inaciose/MC6809x/explorations/freerun/readme.md

Teste free run.

Os dois MC6809P que tenho funcionaram. consumos: 10mA e 11mA.

Inicialmente esqueci-me do condensador de 100n no VCC do MC6809. Não aparece no esquema mas deve ser colocado.
Adicionei duas imagens com a variação do VCC com o condensador. Todas as outras imagens são sem o condensador, mas não vi variações significativas nos sinais.
