inaciose/MC6809x/explorations/readme.md

Exploração de sistemas usados em MC6809 SBC
