inaciose/MC6809x/explorations/clock_circuit/clock_circuit.png

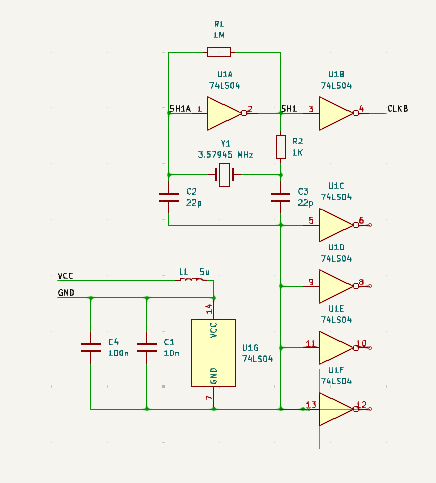
explorations/clock_circuit/clock_circuit.png
