inaciose/MC6809x/explorations/clock_circuit/clock_new.jpg

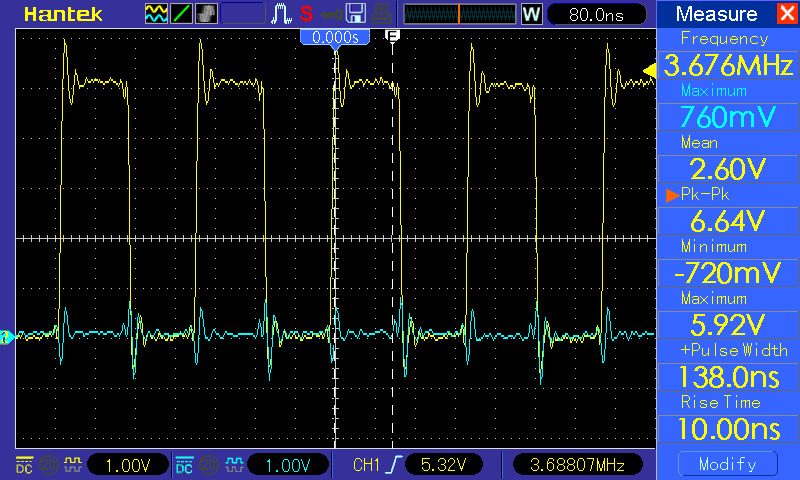
explorations/clock_circuit/clock_new.jpg
