inaciose/MC6809x/explorations/clock_circuit/vcc_gnd_new_080ns.jpg

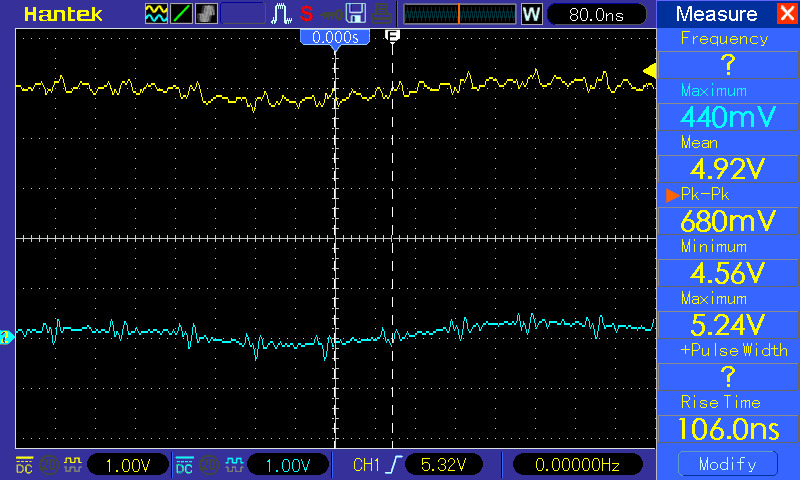
explorations/clock_circuit/vcc_gnd_new_080ns.jpg
