inaciose/MC6809x/explorations/freerun/A2.jpg

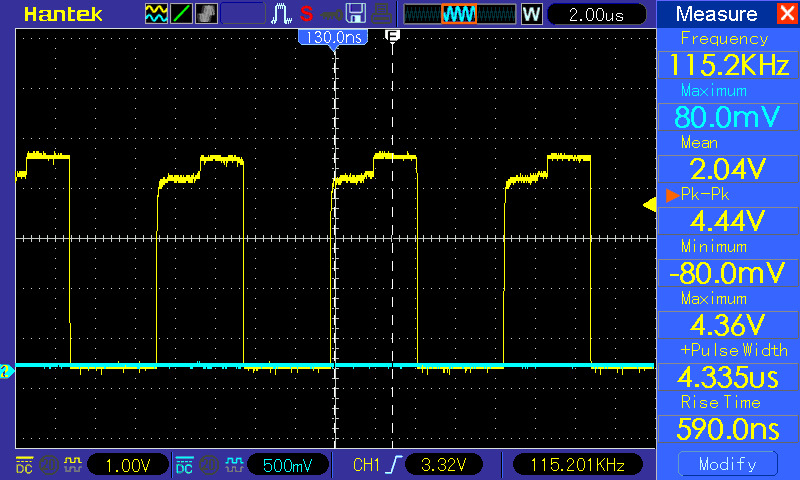
explorations/freerun/A2.jpg
