inaciose/MC6809x/explorations/freerun/A3.jpg

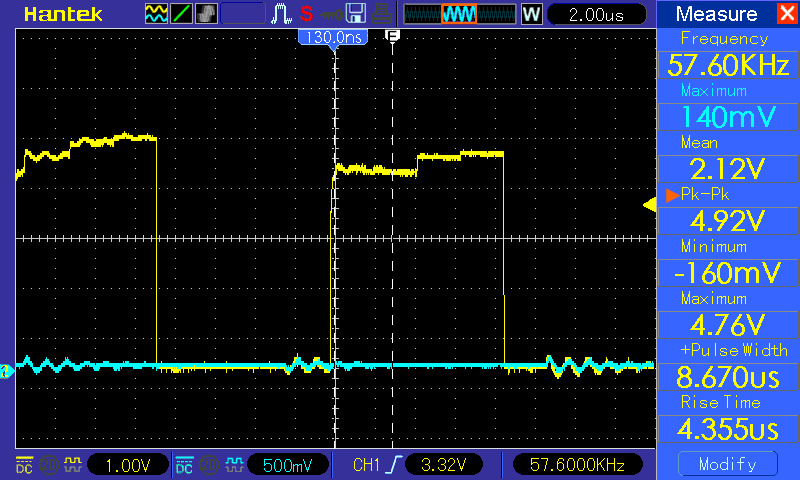
explorations/freerun/A3.jpg
