inaciose/MC6809x/explorations/freerun/E.jpg

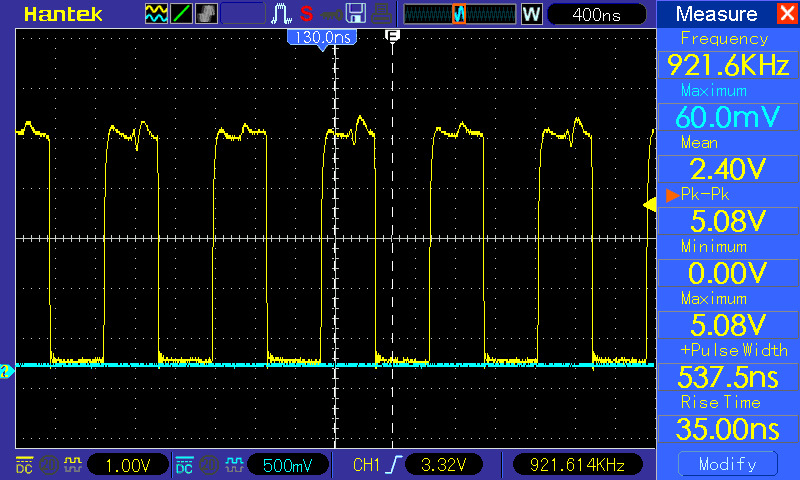
explorations/freerun/E.jpg
