inaciose/MC6809x/explorations/freerun/MC6809_free_run_circuit.png

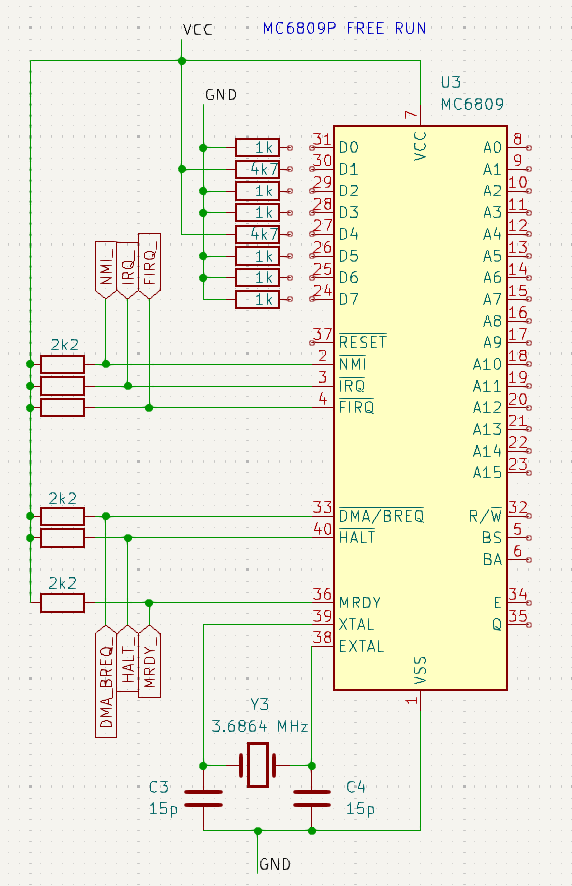
explorations/freerun/MC6809_free_run_circuit.png
