inaciose/MC6809x/explorations/freerun/vcc_4us.jpg

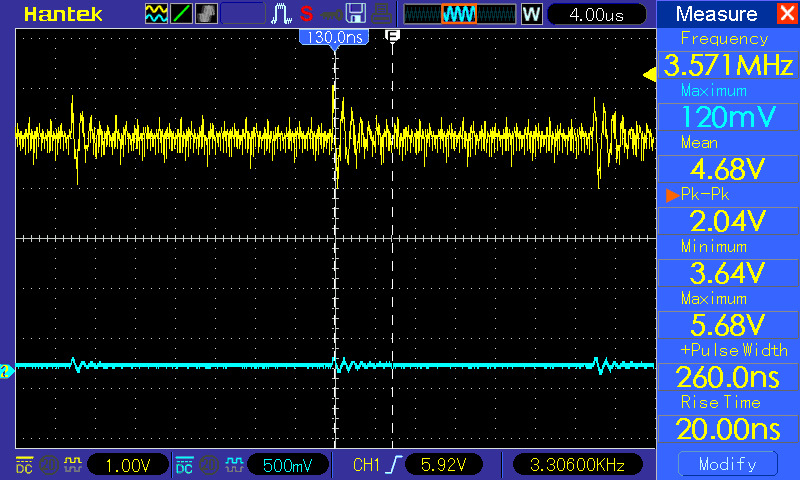
explorations/freerun/vcc_4us.jpg
