inaciose/MC6809x/explorations/freerun/vcc_4us_wcap100n.jpg

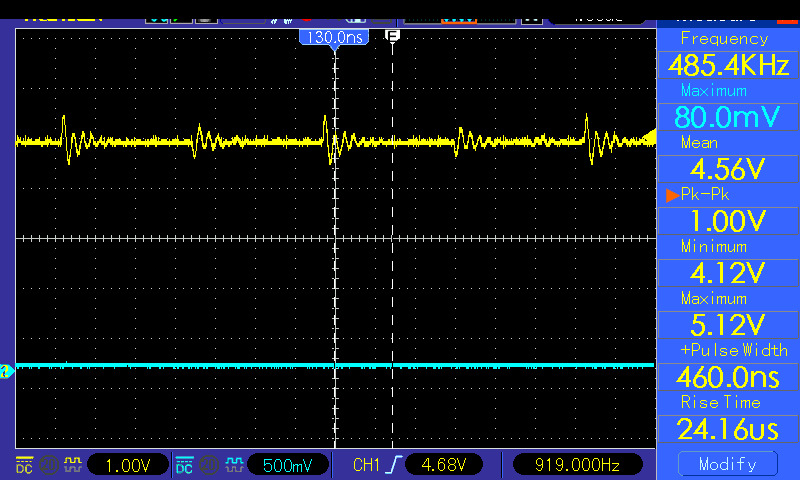
explorations/freerun/vcc_4us_wcap100n.jpg
