inaciose/MC6809x/explorations/MC6809_SBC1/breadboard.jpg

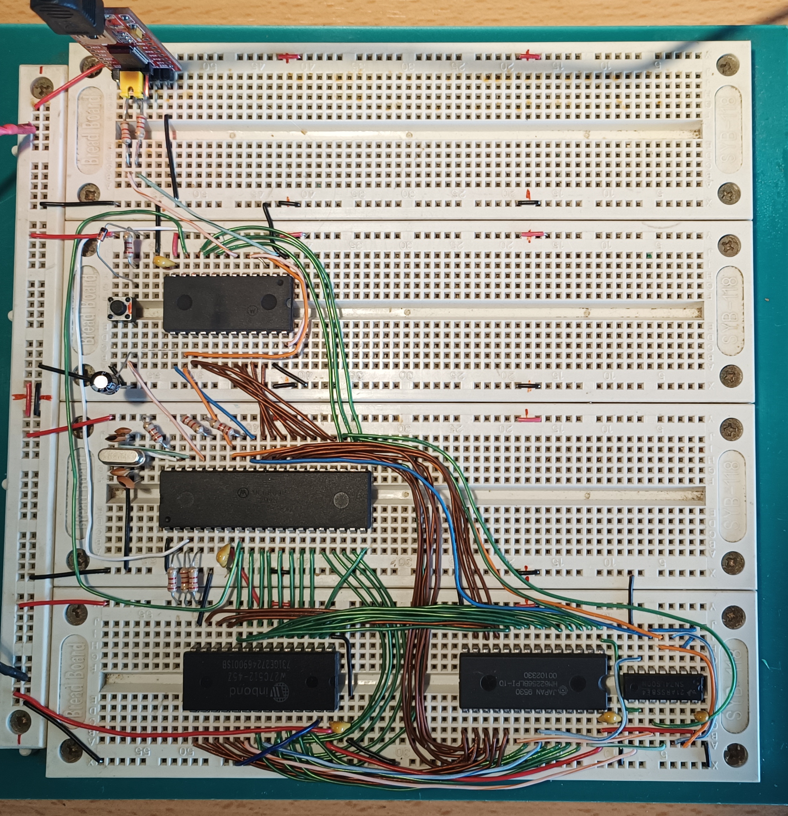
explorations/MC6809_SBC1/breadboard.jpg
