inaciose/MC6809x/explorations/MC6809_SBC2/GALs/LA-captures/MC6809-sbc2a-output-read-write1.png

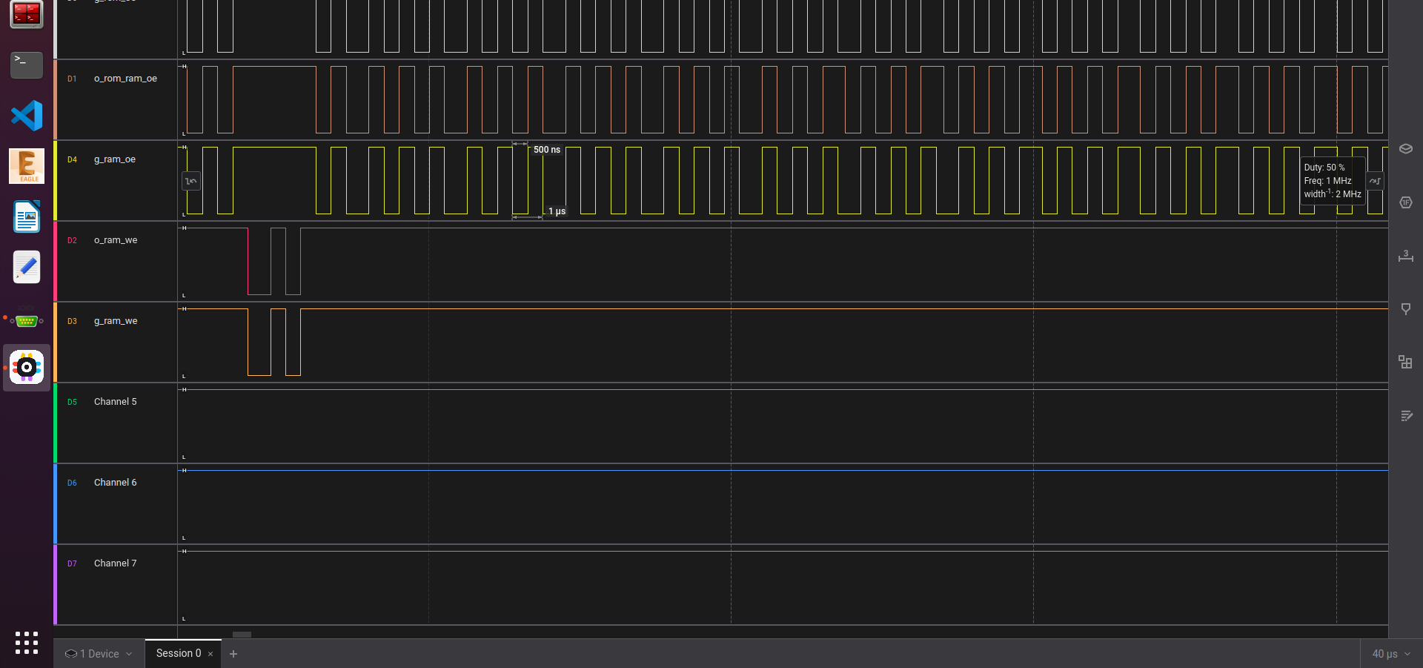
explorations/MC6809_SBC2/GALs/LA-captures/MC6809-sbc2a-output-read-write1.png
