inaciose/MC6809x/explorations/MC6809_SBC2/MC6809-SBC2A-BB.jpeg

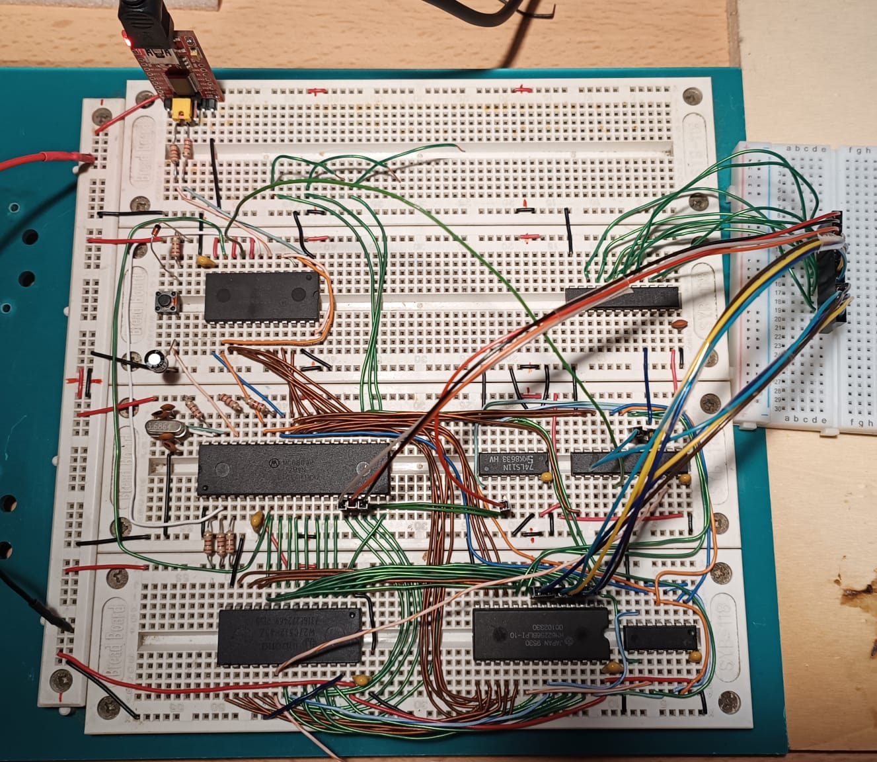
explorations/MC6809_SBC2/MC6809-SBC2A-BB.jpeg
