inaciose/MC6809x/explorations/MC6809_SBC2/MC6809-SBC2A-ROM-FIRST-BYTES-OK.png

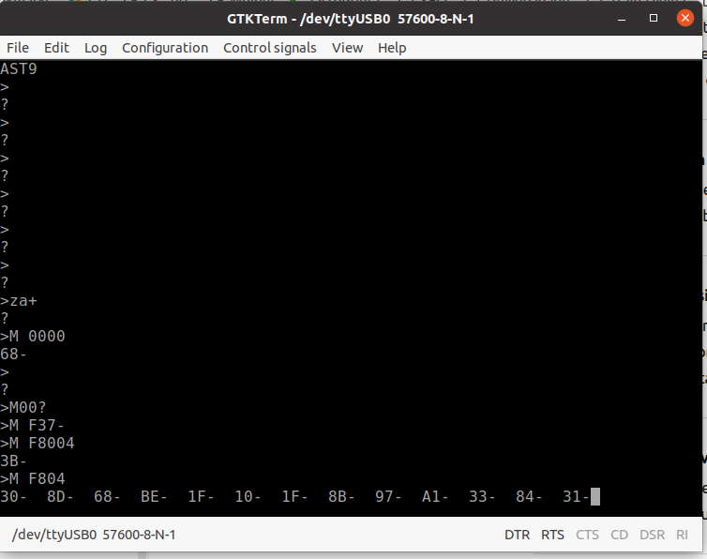
explorations/MC6809_SBC2/MC6809-SBC2A-ROM-FIRST-BYTES-OK.png
