inaciose/MC6809x/explorations/MC6809_SBC2/MC6809-SBC2B-BB_32K.jpg

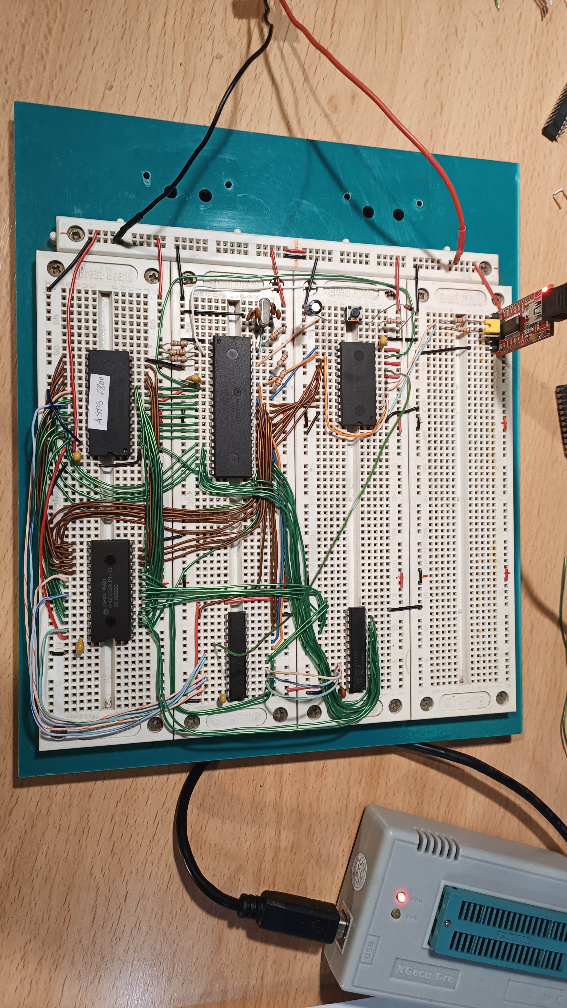
explorations/MC6809_SBC2/MC6809-SBC2B-BB_32K.jpg
