inaciose/MC6809x/explorations/MC6809_SBC2/MC6809-SBC2C-BB_64K.jpg

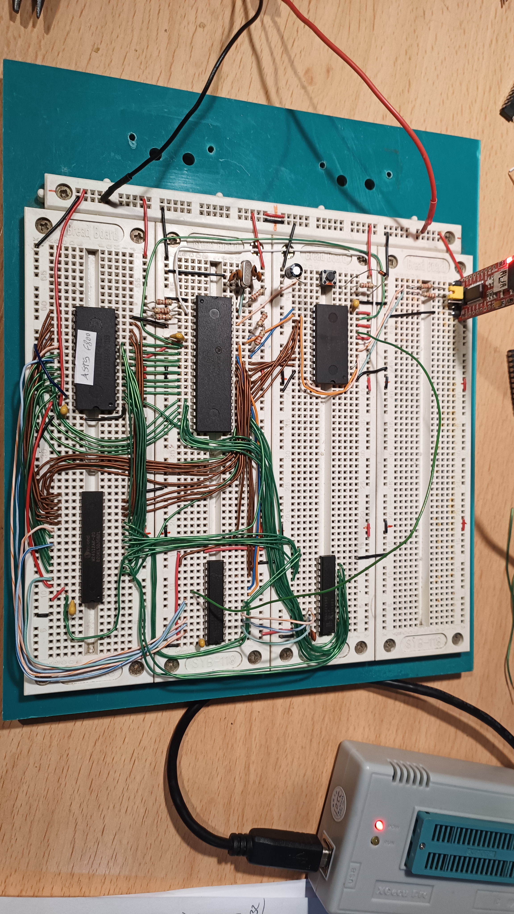
explorations/MC6809_SBC2/MC6809-SBC2C-BB_64K.jpg
