inaciose/MC6809x/explorations/MC6809_SBC3/mc6809_47_bb.jpg

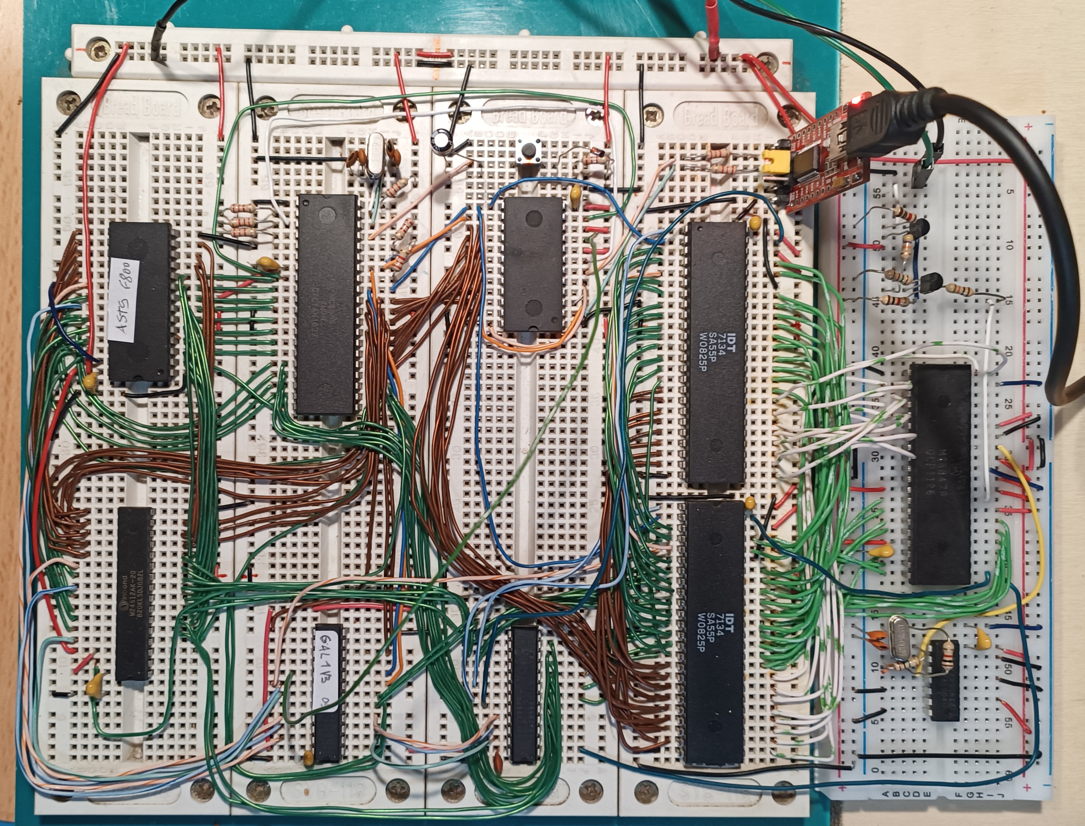
explorations/MC6809_SBC3/mc6809_47_bb.jpg
