inaciose/MC6809x/explorations/singlestep/68kdtack_button_pressed_80ns.jpg

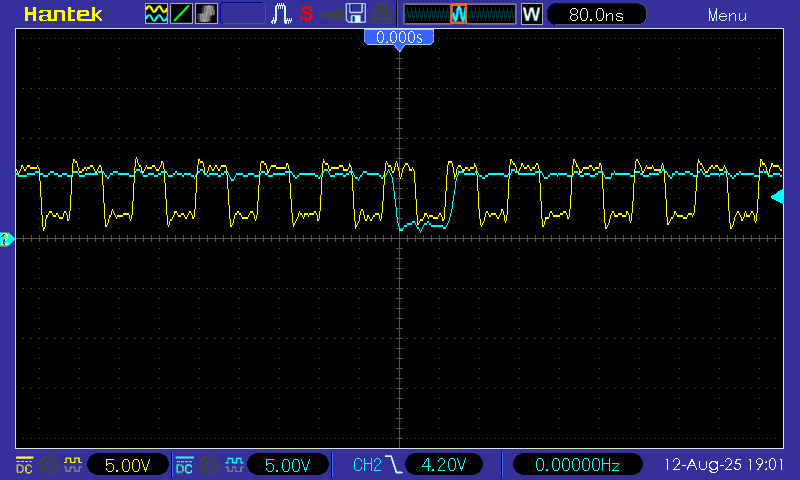
explorations/singlestep/68kdtack_button_pressed_80ns.jpg
