inaciose/MC6809x/explorations/singlestep/68kdtack_waiting_for_button.jpg

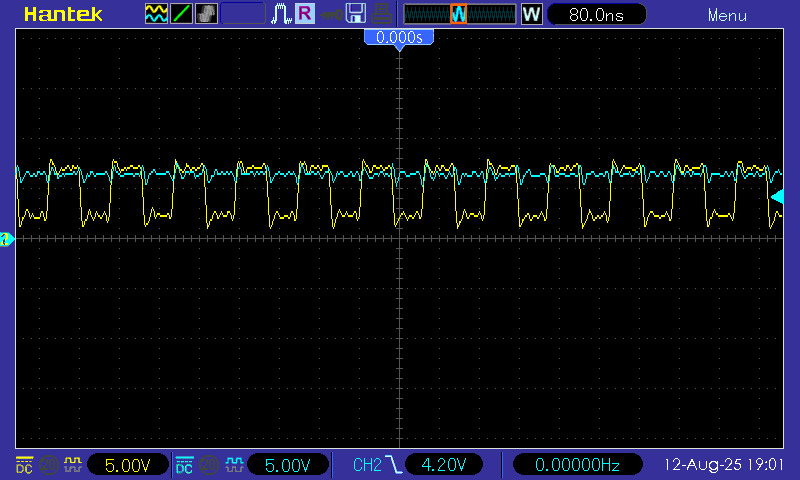
explorations/singlestep/68kdtack_waiting_for_button.jpg
