inaciose/MC6809x/explorations/singlestep/IMG_20250831_115116.jpg

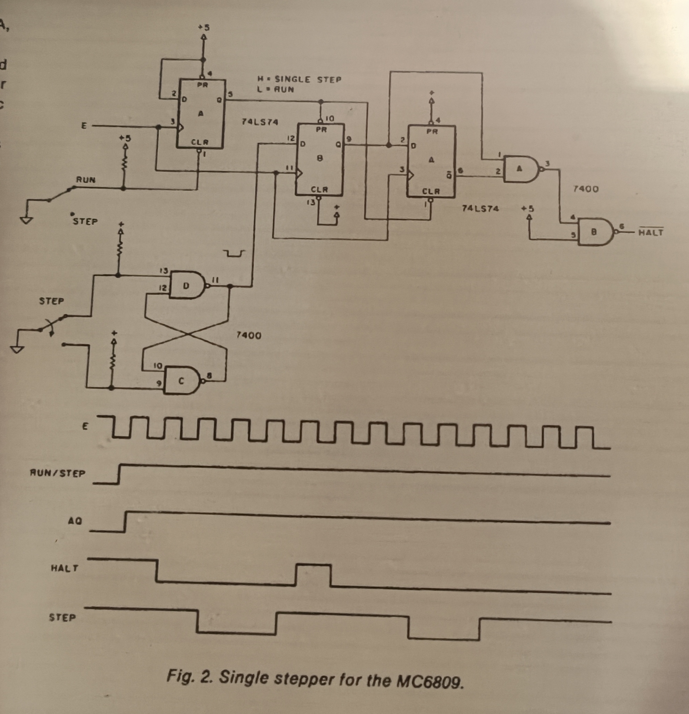
explorations/singlestep/IMG_20250831_115116.jpg
