inaciose/MC6809x/explorations/MC6809_SBC1/MC6809_SBC1_FW/bom.ods

Parts List – 6809 Single Board Computer
Identifier | Qty | Pins | Part | Description | Value | Comments
C1 | 1 | 2 | - | Capacitor, Electrolytic | 10uF | 10V or higher
C2-C3 | 2 | 2 | - | Capacitor, ceramic | 18pF | Or similar value
C3 | 1 | 2 | - | Capacitor, ceramic | 18pF | Or similar value
C4-C8 | 5 | 2 | - | Capacitor, ceramic | 0.1uF | Bypass caps, 1 per IC
D1 | 1 | 2 | 1N914 | Diode, small signal | - | Or 1N4148
H1 | 1 | 2 | - | 1x2 header + jumper | - | USB power jumper
H2 | 1 | 32 | - | 2x16 header | - | Expansion connector
LED1 | 1 | 2 | - | LED, red | - | Power LED
P1 | 1 | 6 | - | 1x6 header | - | For USB to serial module
R1 | 1 | 2 | - | Resistor | 330R | For power LED (adjust value for desired brightness)
RN1 | 1 | 9 | - | SIP resistor, 9X1 | 2K2 | Pullups
SW1 | 1 | 4 | - | Switch, momentary, SPST | - | Reset switch
U1 | 1 | 24 | 68B50 | ACIA | - | Be sure to get “B” part
U2 | 1 | 28 | 27C128 | 16K EPROM | - | Or 27128
U3 | 1 | 28 | 62256 | 32K Static RAM | - | Speed not critical
U4 | 1 | 40 | 68B09 | Microprocessor | - | Be sure to get B version and not 68089E
U5 | 1 | 14 | 74LS00 | Quad 2-input NAND gate | -
X1 | 1 | 2 | - | Crystal, 7.3728 MHz | - | Clock
- | 1 | 6 | - | FTDI module | - | USB to serial module. e.g. FTDI Friend
- | - | - | - | IC sockets | - | As needed
