inaciose/MC6809x/explorations/MC6809_SBC2/MC6809_SBC2_schematic.pdf

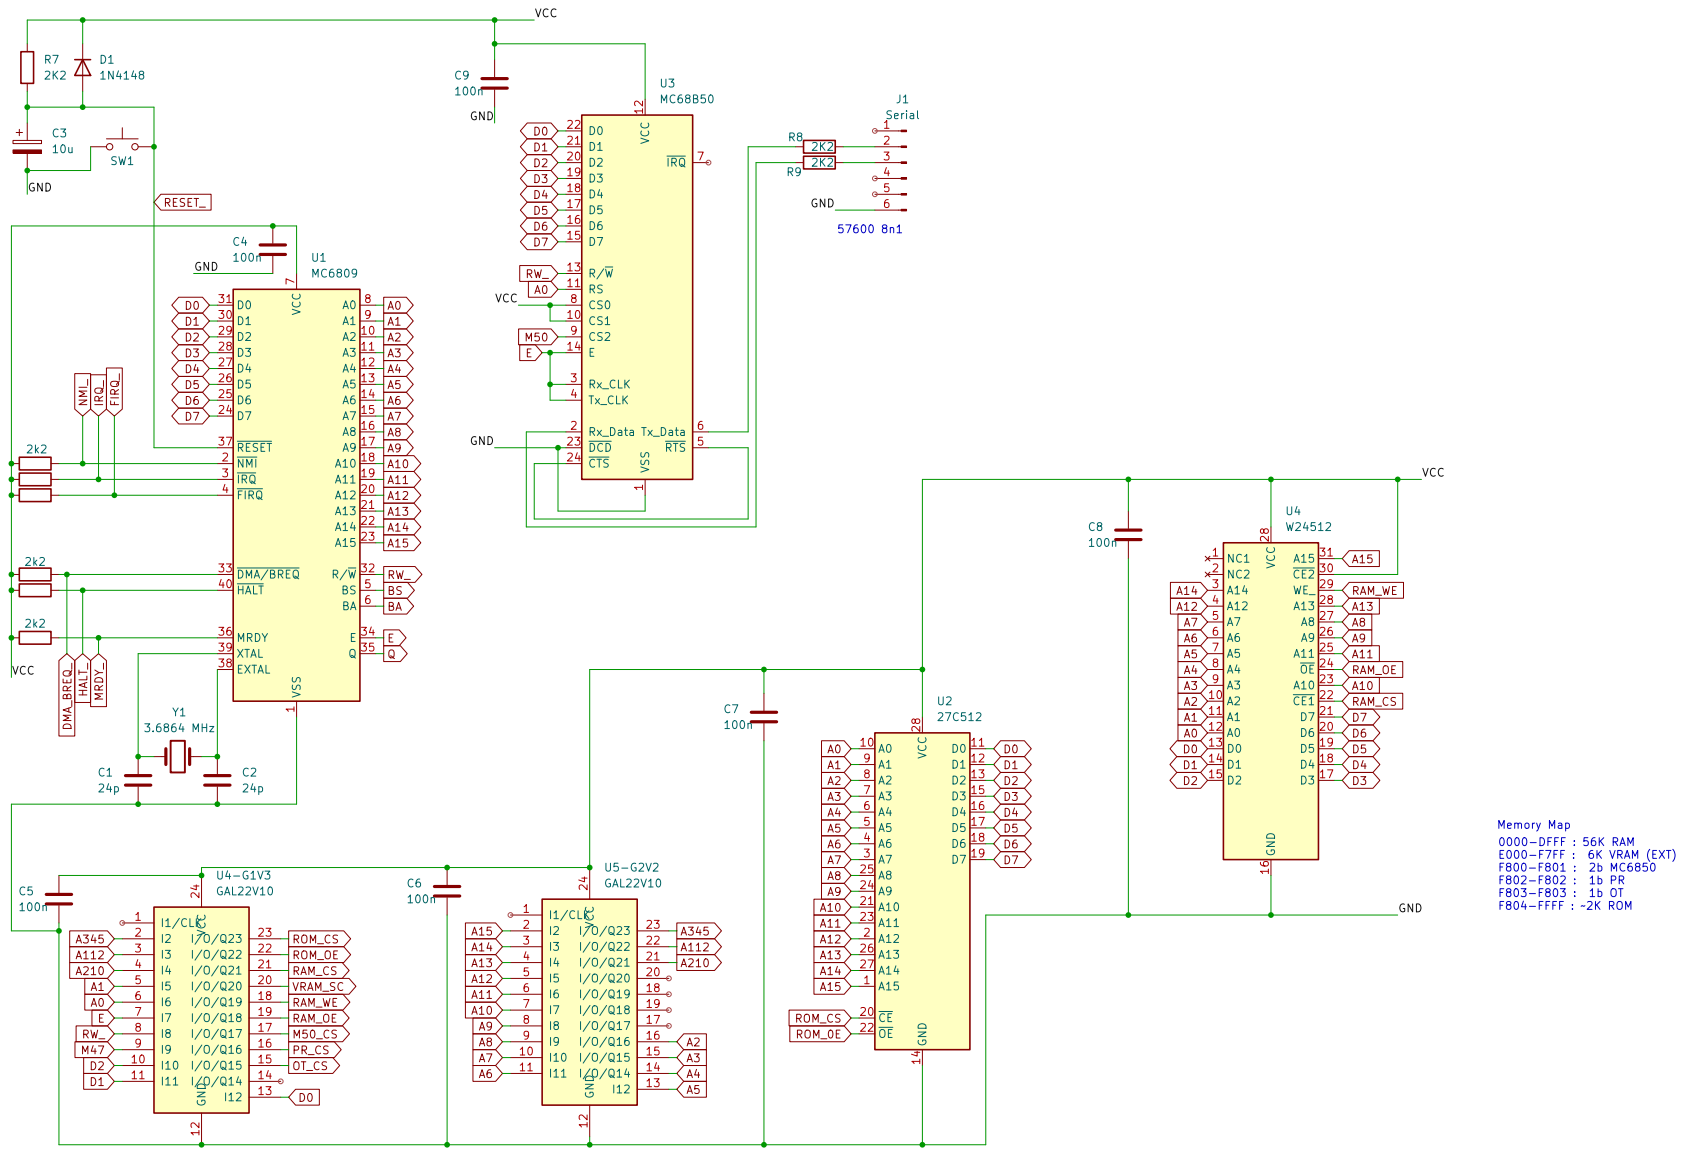
[picture p24: page 1]
