inaciose/MC6809x/explorations/MC6809_SBC1/MC6809_SBC1_schematic.pdf

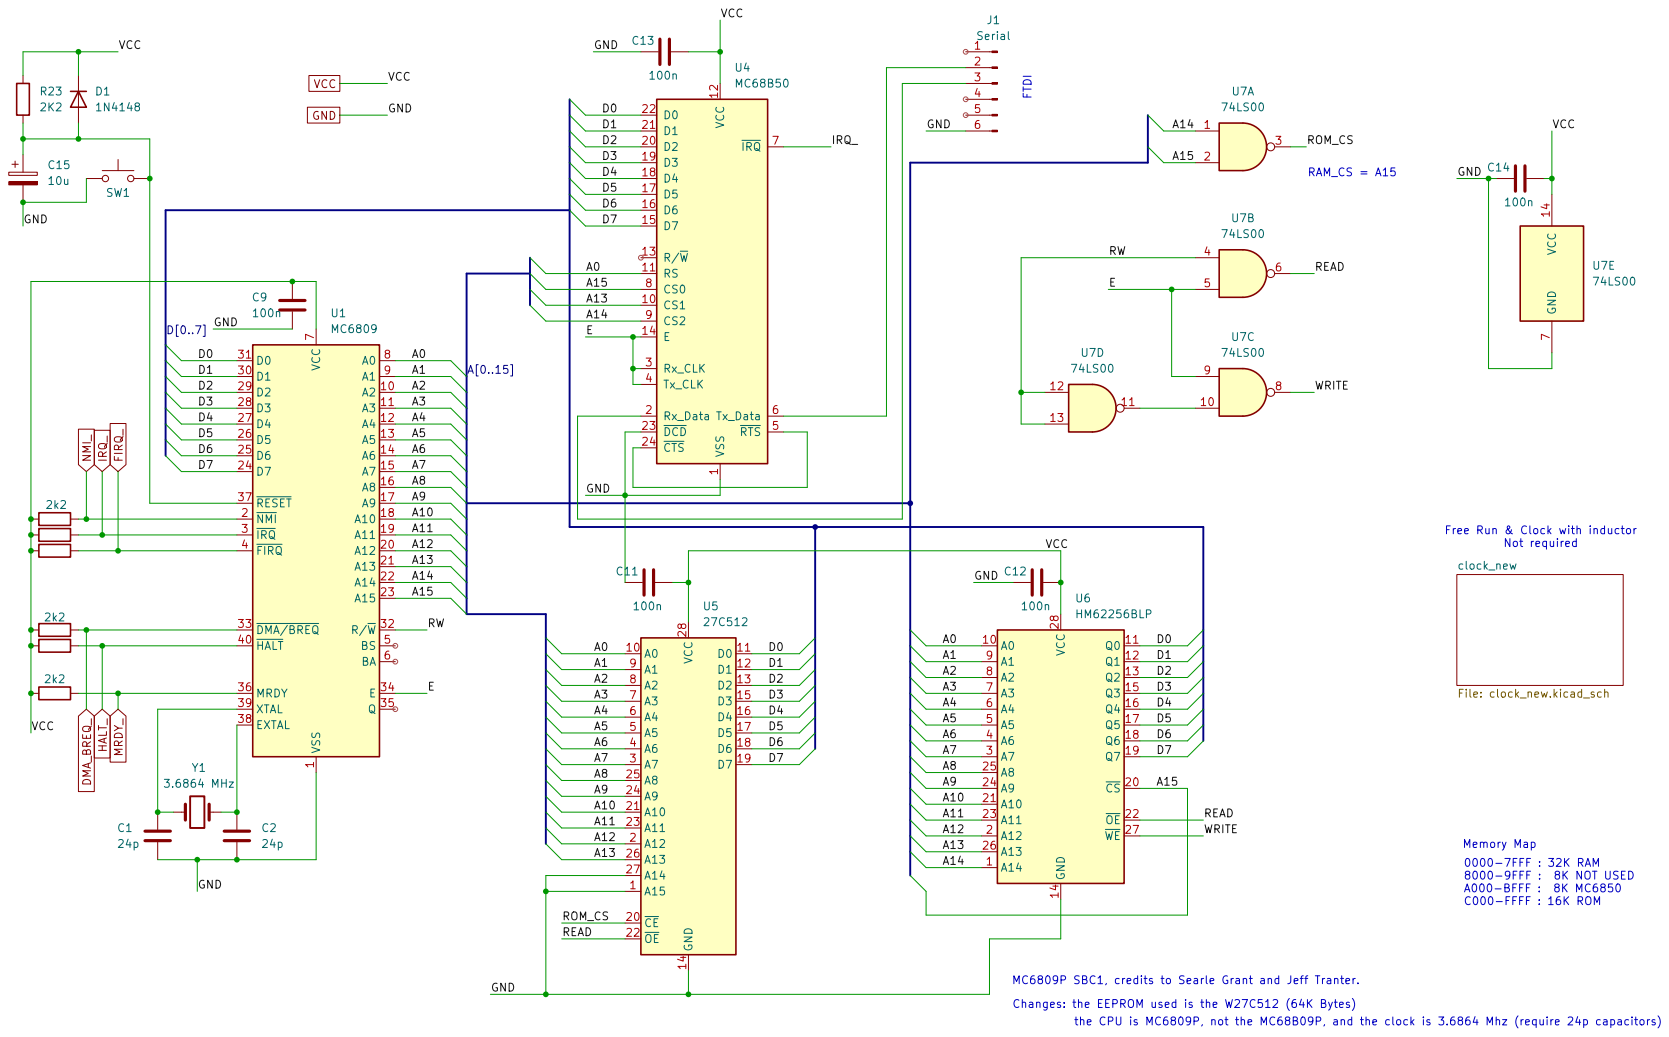
[picture p25: page 1]

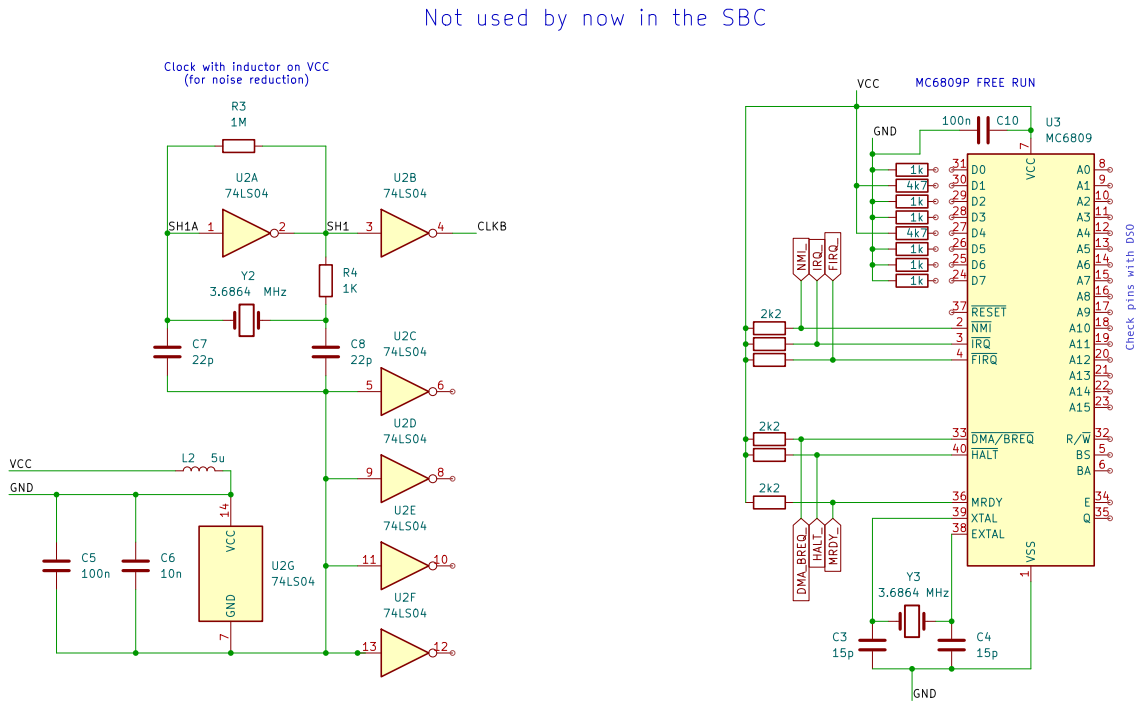
[picture p26: page 2]
