inaciose/MC6809x/explorations/MC6809_SBC3/mc6809_sbc3.pdf

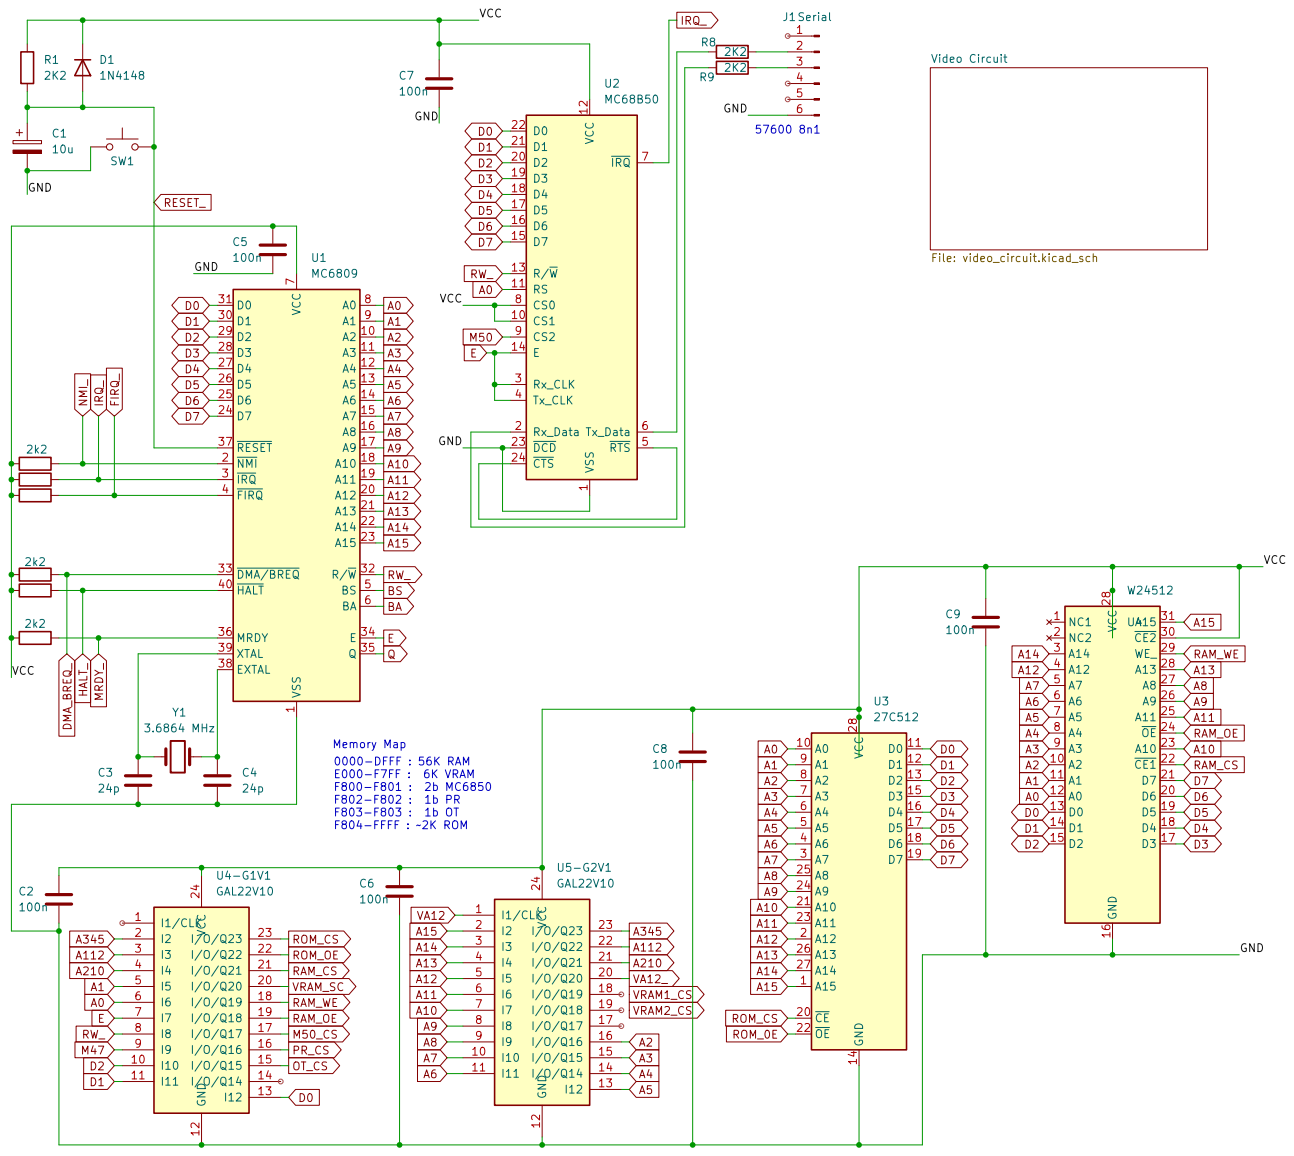
[picture p27: page 1]

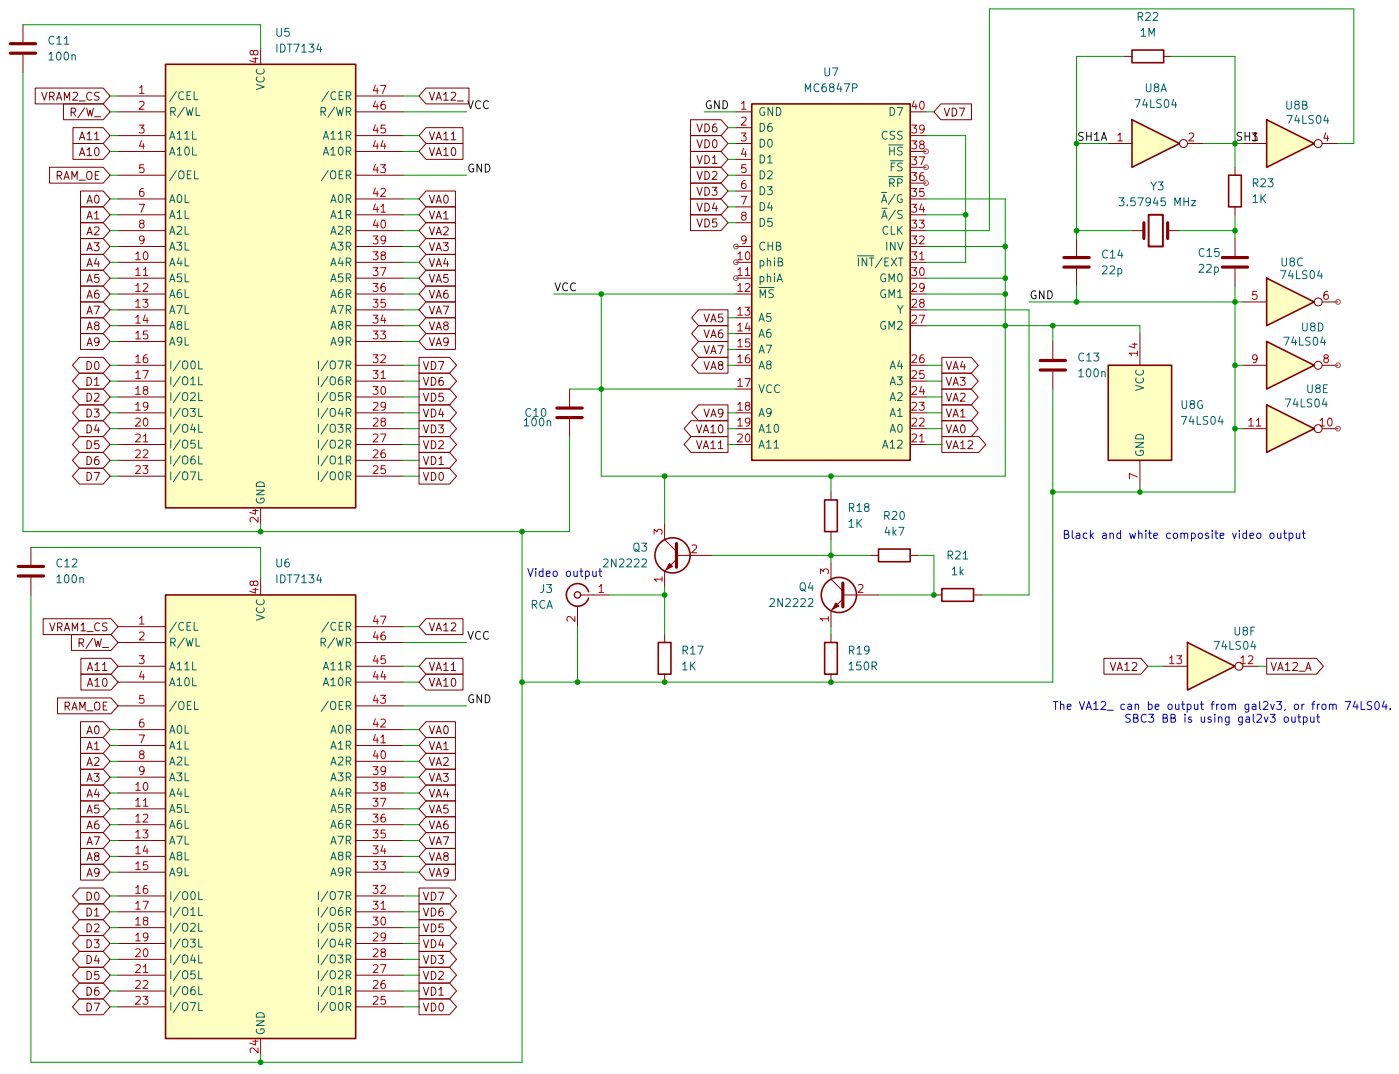
[picture p28: page 2]
