inaciose/MC6809x/explorations/MC6809_SBC1/MC6809_SBC1/MC6809_SBC1.kicad_sch

## KiCad design explorations/MC6809_SBC1/MC6809_SBC1/MC6809_SBC1.kicad_sch (2025-08-09)

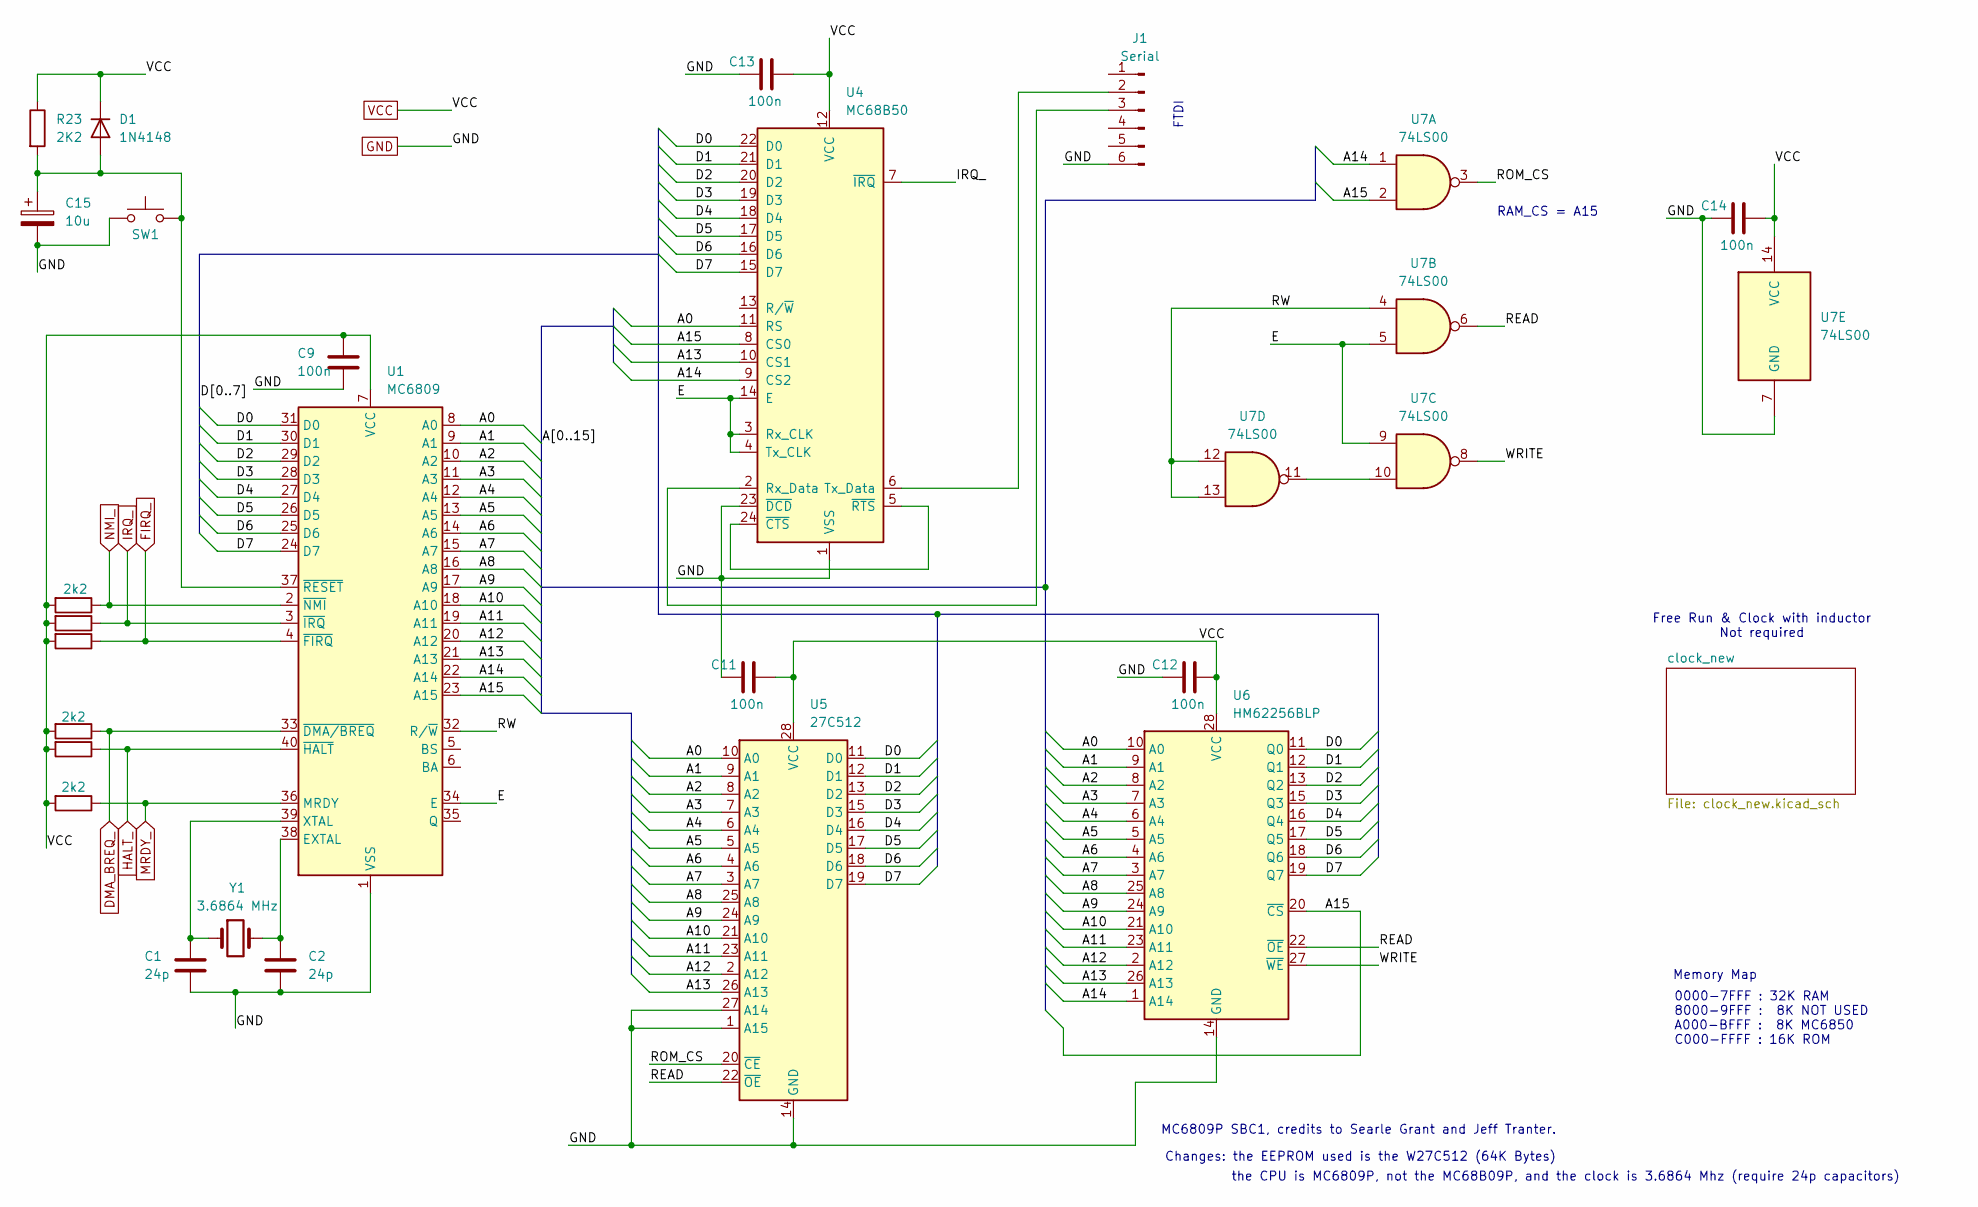
[picture p29: schematic MC6809_SBC1.kicad_sch]

Parts:
C1, C2: 24p; C_Disc_D3.0mm_W1.6mm_P2.50mm
C9, C11, C12, C13, C14: 100n; C_Disc_D3.0mm_W1.6mm_P2.50mm
C15: 10u
D1: 1N4148; D_DO-35_SOD27_P7.62mm_Horizontal
J1: Serial
R1, R2, R5, R6, R7, R8: 2k2; R_Axial_DIN0207_L6.3mm_D2.5mm_P7.62mm_Horizontal
R23: 2K2; R_Axial_DIN0207_L6.3mm_D2.5mm_P7.62mm_Horizontal
SW1: V
U1: MC6809; DIP-40_W15.24mm
U4: MC68B50; DIP-24_W15.24mm
U5: 27C512; DIP-28_W15.24mm
U6: HM62256BLP; DIP-28_W15.24mm
U7: 74LS00
Y1: 3.6864 MHz; Resonator-2Pin_W10.0mm_H5.0mm

Connections:
A0: U1.8 (A0), U4.11 (RS), U5.10 (A0), U6.10 (A0)
A1: U1.9 (A1), U5.9 (A1), U6.9 (A1)
A2: U1.10 (A2), U5.8 (A2), U6.8 (A2)
A3: U1.11 (A3), U5.7 (A3), U6.7 (A3)
A4: U1.12 (A4), U5.6 (A4), U6.6 (A4)
A5: U1.13 (A5), U5.5 (A5), U6.5 (A5)
A6: U1.14 (A6), U5.4 (A6), U6.4 (A6)
A7: U1.15 (A7), U5.3 (A7), U6.3 (A7)
A8: U1.16 (A8), U5.25 (A8), U6.25 (A8)
A9: U1.17 (A9), U5.24 (A9), U6.24 (A9)
A10: U1.18 (A10), U5.21 (A10), U6.21 (A10)
A11: U1.19 (A11), U5.23 (A11), U6.23 (A11)
A12: U1.20 (A12), U5.2 (A12), U6.2 (A12)
A13: U1.21 (A13), U4.10 (CS1), U5.26 (A13), U6.26 (A13)
A14: U1.22 (A14), U4.9 (CS2), U6.1 (A14), U7.1
A15: U1.23 (A15), U4.8 (CS0), U6.20 (~CS), U7.2
D0: U1.31 (D0), U4.22 (D0), U5.11 (D0), U6.11 (Q0)
D1: U1.30 (D1), U4.21 (D1), U5.12 (D1), U6.12 (Q1)
D2: U1.29 (D2), U4.20 (D2), U5.13 (D2), U6.13 (Q2)
D3: U1.28 (D3), U4.19 (D3), U5.15 (D3), U6.15 (Q3)
D4: U1.27 (D4), U4.18 (D4), U5.16 (D4), U6.16 (Q4)
D5: U1.26 (D5), U4.17 (D5), U5.17 (D5), U6.17 (Q5)
D6: U1.25 (D6), U4.16 (D6), U5.18 (D6), U6.18 (Q6)
D7: U1.24 (D7), U4.15 (D7), U5.19 (D7), U6.19 (Q7)
DMA_BREQ_: R7.1, U1.33 (~DMA/BREQ)
E: U1.34 (E), U4.3 (Rx_CLK), U4.4 (Tx_CLK), U4.14 (E), U7.5, U7.9
FIRQ_: R5.1, U1.4 (~FIRQ)
GND: C1.2, C2.2, C9.2, C11.1, C12.1, C13.1, C14.1, C15.2, J1.6, SW1.1, U1.1 (VSS), U4.1 (VSS), U4.23 (~DCD), U5.1 (A15), U5.14 (GND), U5.27 (A14), U6.14 (GND), U7.7 (GND)
HALT_: R8.1, U1.40 (~HALT)
IRQ_: R1.1, U1.3 (~IRQ), U4.7 (~IRQ)
MRDY_: R2.1, U1.36 (MRDY)
NMI_: R6.1, U1.2 (~NMI)
unnamed: C1.1, U1.39 (XTAL), Y1.1
unnamed: C2.1, U1.38 (EXTAL), Y1.2
unnamed: C15.1, D1.2 (A), R23.2, SW1.2, U1.37 (~RESET)
unnamed: J1.2, U4.6 (Tx_Data)
unnamed: J1.3, U4.2 (Rx_Data)
unnamed: U4.5 (~RTS), U4.24 (~CTS)
unnamed: U7.10, U7.11
READ: U5.22 (~OE), U6.22 (~OE), U7.6
ROM_CS: U5.20 (~CE), U7.3
RW: U1.32 (R/~W), U7.4, U7.12, U7.13
VCC: C9.1, C11.2, C12.2, C13.2, C14.2, D1.1 (K), R1.2, R2.2, R5.2, R6.2, R7.2, R8.2, R23.1, U1.7 (VCC), U4.12 (VCC), U5.28 (VCC), U6.28 (VCC), U7.14 (VCC)
WRITE: U6.27 (~WE), U7.8

Notes on the sheet:
Memory Map
MC6809P SBC1, credits to Searle Grant and Jeff Tranter.
Changes: the EEPROM used is the W27C512 (64K Bytes)
0000-7FFF : 32K RAM 8000-9FFF : 8K NOT USED A000-BFFF : 8K MC6850 C000-FFFF : 16K ROM
Free Run & Clock with inductor Not required
RAM_CS = A15
the CPU is MC6809P, not the MC68B09P, and the clock is 3.6864 Mhz (require 24p capacitors)
FTDI
