inaciose/MC6809x/explorations/MC6809_SBC1/MC6809_SBC1/clock_new.kicad_sch

## KiCad design explorations/MC6809_SBC1/MC6809_SBC1/clock_new.kicad_sch (2025-08-09)

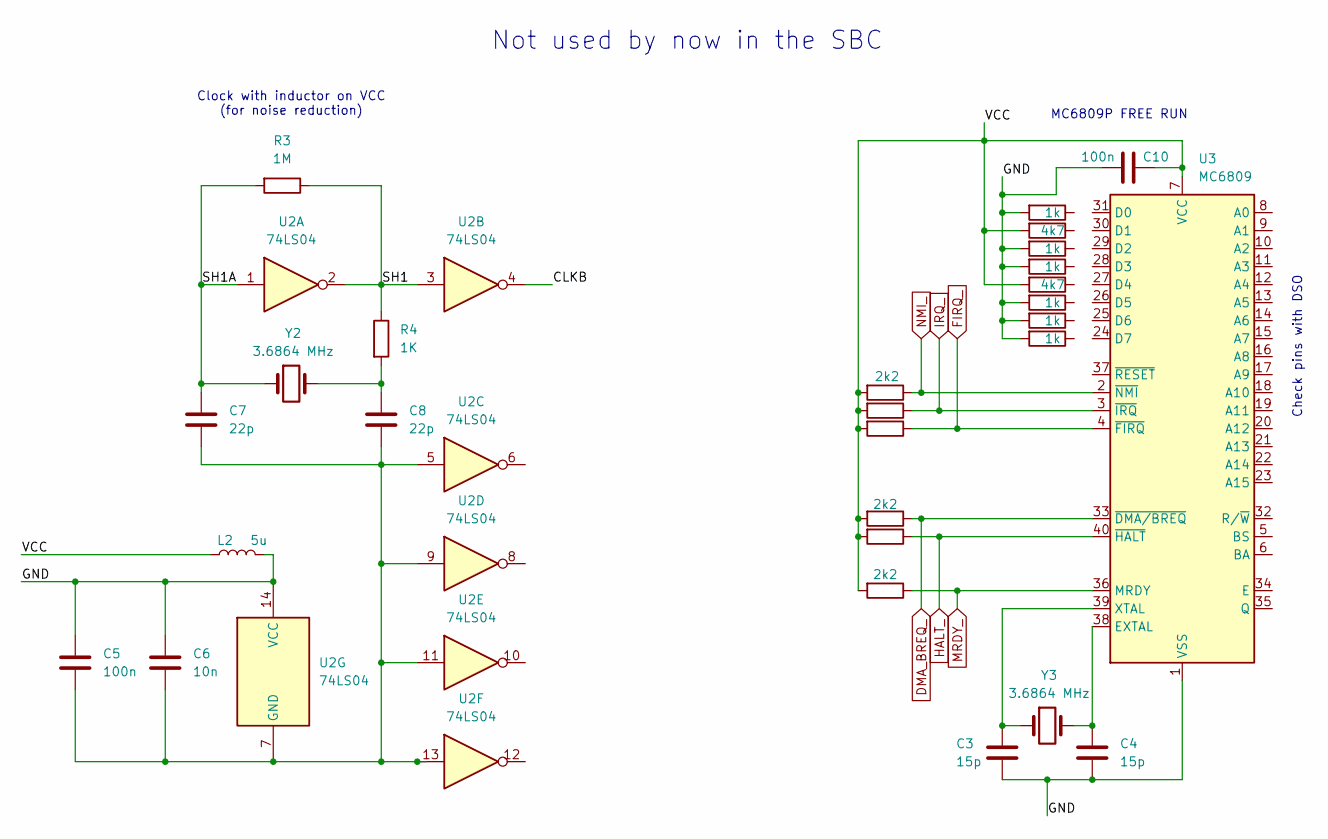
[picture p30: schematic clock_new.kicad_sch]

Parts:
C3, C4: 15p; C_Disc_D3.0mm_W1.6mm_P2.50mm
C5, C10: 100n; C_Disc_D3.0mm_W1.6mm_P2.50mm
C6: 10n; C_Disc_D3.0mm_W1.6mm_P2.50mm
C7, C8: 22p; C_Disc_D3.0mm_W1.6mm_P2.50mm
L2: 5u
R3: 1M; R_Axial_DIN0207_L6.3mm_D2.5mm_P7.62mm_Horizontal
R4: 1K; R_Axial_DIN0207_L6.3mm_D2.5mm_P7.62mm_Horizontal
R9, R10, R11, R12, R13, R14: 2k2; R_Axial_DIN0207_L6.3mm_D2.5mm_P7.62mm_Horizontal
R15, R16, R17, R18, R21, R22: 1k; R_Axial_DIN0207_L6.3mm_D2.5mm_P7.62mm_Horizontal
R19, R20: 4k7; R_Axial_DIN0207_L6.3mm_D2.5mm_P7.62mm_Horizontal
U2: 74LS04
U3: MC6809; DIP-40_W15.24mm
Y2, Y3: 3.6864 MHz; Resonator-2Pin_W10.0mm_H5.0mm

Connections:
CLKB: U2.4
DMA_BREQ_: R12.1, U3.33 (~DMA/BREQ)
FIRQ_: R11.1, U3.4 (~FIRQ)
GND: C3.2, C4.2, C5.1, C6.1, C10.1, L2.2, R15.2, R16.2, R17.2, R18.2, R21.2, R22.2, U2.14 (VCC), U3.1 (VSS)
HALT_: R13.1, U3.40 (~HALT)
IRQ_: R10.1, U3.3 (~IRQ)
MRDY_: R14.1, U3.36 (MRDY)
NMI_: R9.1, U3.2 (~NMI)
unnamed: C3.1, U3.39 (XTAL), Y3.1
unnamed: C4.1, U3.38 (EXTAL), Y3.2
unnamed: C5.2, C6.2, C7.2, C8.2, U2.5, U2.7 (GND), U2.9, U2.11, U2.13
unnamed: C8.1, R4.2, Y2.2
SH1: R3.1, R4.1, U2.2, U2.3
SH1A: C7.1, R3.2, U2.1, Y2.1
VCC: C10.2, L2.1, R9.2, R10.2, R11.2, R12.2, R13.2, R14.2, R19.2, R20.2, U3.7 (VCC)

Notes on the sheet:
MC6809P FREE RUN
Not used by now in the SBC
Clock with inductor on VCC (for noise reduction)
Check pins with DSO
