inaciose/MC6809x/explorations/MC6809_SBC2/MC6809_SBC2/MC6809_SBC2.kicad_sch

## KiCad design explorations/MC6809_SBC2/MC6809_SBC2/MC6809_SBC2.kicad_sch (2025-08-24)

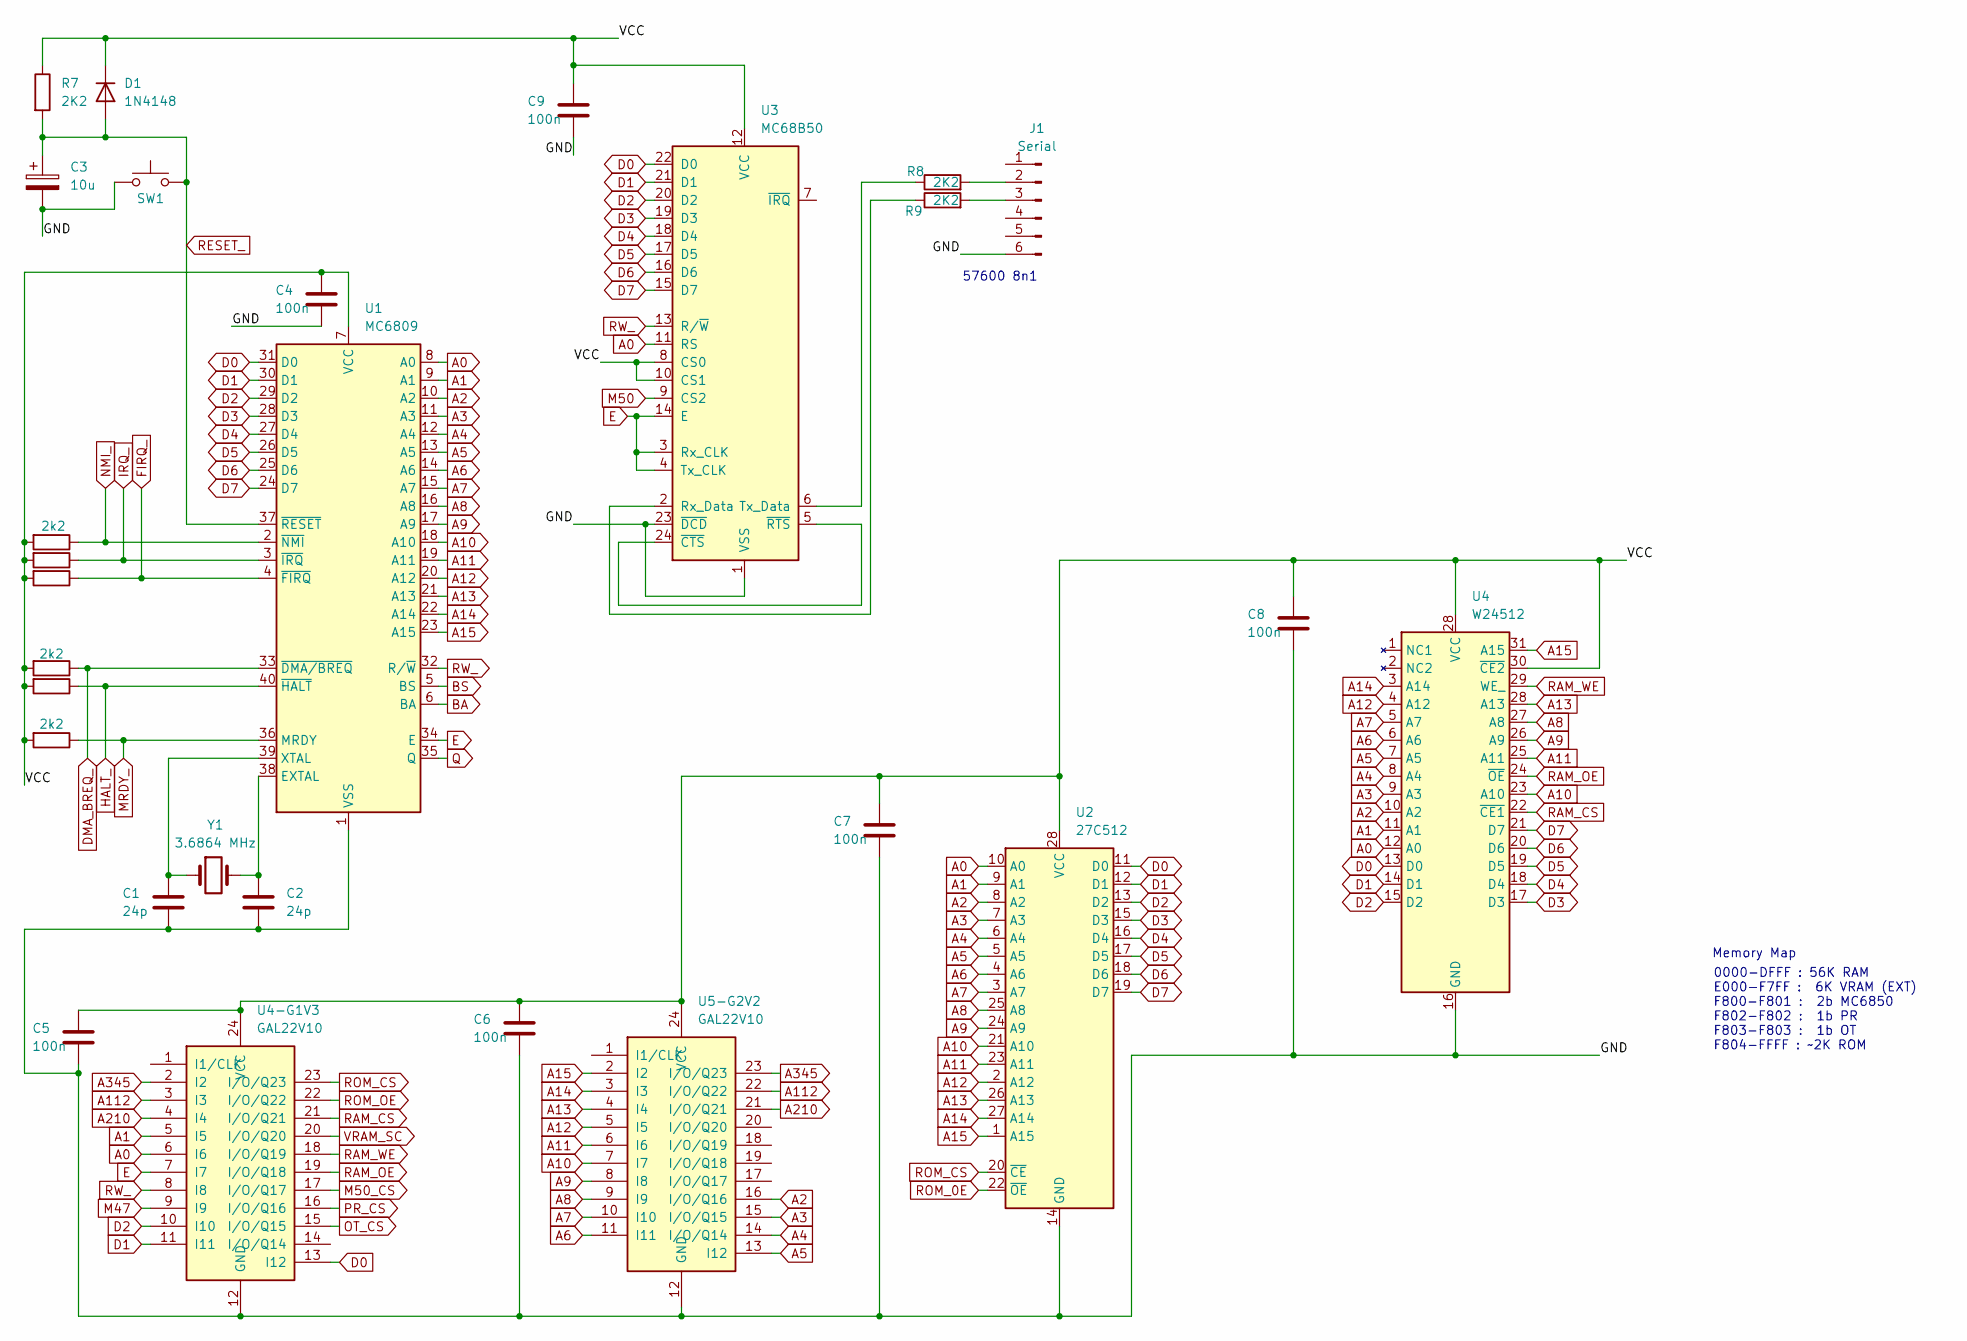
[picture p31: schematic MC6809_SBC2.kicad_sch]

Parts:
C1, C2: 24p; C_Disc_D3.0mm_W1.6mm_P2.50mm
C3: 10u
C4, C5, C6, C7, C8, C9: 100n; C_Disc_D3.0mm_W1.6mm_P2.50mm
D1: 1N4148; D_DO-35_SOD27_P7.62mm_Horizontal
J1: Serial
R1, R2, R3, R4, R5, R6: 2k2; R_Axial_DIN0207_L6.3mm_D2.5mm_P7.62mm_Horizontal
R7, R8, R9: 2K2; R_Axial_DIN0207_L6.3mm_D2.5mm_P7.62mm_Horizontal
SW1: V
U1: MC6809; DIP-40_W15.24mm
U2: 27C512; DIP-28_W15.24mm
U3: MC68B50; DIP-24_W15.24mm
U4: W24512; DIP-32_Narrow
U4-G1V3, U5-G2V2: GAL22V10
Y1: 3.6864 MHz; Resonator-2Pin_W10.0mm_H5.0mm

Connections:
A0: U1.8 (A0), U2.10 (A0), U3.11 (RS), U4.12 (A0), U4-G1V3.6 (I6)
A1: U1.9 (A1), U2.9 (A1), U4.11 (A1), U4-G1V3.5 (I5)
A2: U1.10 (A2), U2.8 (A2), U4.10 (A2), U5-G2V2.16 (I/O/Q16)
A3: U1.11 (A3), U2.7 (A3), U4.9 (A3), U5-G2V2.15 (I/O/Q15)
A4: U1.12 (A4), U2.6 (A4), U4.8 (A4), U5-G2V2.14 (I/O/Q14)
A5: U1.13 (A5), U2.5 (A5), U4.7 (A5), U5-G2V2.13 (I12)
A6: U1.14 (A6), U2.4 (A6), U4.6 (A6), U5-G2V2.11 (I11)
A7: U1.15 (A7), U2.3 (A7), U4.5 (A7), U5-G2V2.10 (I10)
A8: U1.16 (A8), U2.25 (A8), U4.27 (A8), U5-G2V2.9 (I9)
A9: U1.17 (A9), U2.24 (A9), U4.26 (A9), U5-G2V2.8 (I8)
A10: U1.18 (A10), U2.21 (A10), U4.23 (A10), U5-G2V2.7 (I7)
A11: U1.19 (A11), U2.23 (A11), U4.25 (A11), U5-G2V2.6 (I6)
A12: U1.20 (A12), U2.2 (A12), U4.4 (A12), U5-G2V2.5 (I5)
A13: U1.21 (A13), U2.26 (A13), U4.28 (A13), U5-G2V2.4 (I4)
A14: U1.22 (A14), U2.27 (A14), U4.3 (A14), U5-G2V2.3 (I3)
A15: U1.23 (A15), U2.1 (A15), U4.31 (A15), U5-G2V2.2 (I2)
A112: U4-G1V3.3 (I3), U5-G2V2.22 (I/O/Q22)
A210: U4-G1V3.4 (I4), U5-G2V2.21 (I/O/Q21)
A345: U4-G1V3.2 (I2), U5-G2V2.23 (I/O/Q23)
BA: U1.6 (BA)
BS: U1.5 (BS)
D0: U1.31 (D0), U2.11 (D0), U3.22 (D0), U4.13 (D0), U4-G1V3.13 (I12)
D1: U1.30 (D1), U2.12 (D1), U3.21 (D1), U4.14 (D1), U4-G1V3.11 (I11)
D2: U1.29 (D2), U2.13 (D2), U3.20 (D2), U4.15 (D2), U4-G1V3.10 (I10)
D3: U1.28 (D3), U2.15 (D3), U3.19 (D3), U4.17 (D3)
D4: U1.27 (D4), U2.16 (D4), U3.18 (D4), U4.18 (D4)
D5: U1.26 (D5), U2.17 (D5), U3.17 (D5), U4.19 (D5)
D6: U1.25 (D6), U2.18 (D6), U3.16 (D6), U4.20 (D6)
D7: U1.24 (D7), U2.19 (D7), U3.15 (D7), U4.21 (D7)
DMA_BREQ_: R4.1, U1.33 (~DMA/BREQ)
E: U1.34 (E), U3.3 (Rx_CLK), U3.4 (Tx_CLK), U3.14 (E), U4-G1V3.7 (I7)
FIRQ_: R3.1, U1.4 (~FIRQ)
GND: C1.2, C2.2, C3.2, C4.2, C5.2, C6.2, C7.2, C8.2, C9.2, J1.6, SW1.1, U1.1 (VSS), U2.14 (GND), U3.1 (VSS), U3.23 (~DCD), U4.16 (GND), U4-G1V3.12 (GND), U5-G2V2.12 (GND)
HALT_: R5.1, U1.40 (~HALT)
IRQ_: R2.1, U1.3 (~IRQ)
M47: U4-G1V3.9 (I9)
M50: U3.9 (CS2)
M50_CS: U4-G1V3.17 (I/O/Q17)
MRDY_: R6.1, U1.36 (MRDY)
NMI_: R1.1, U1.2 (~NMI)
unnamed: C1.1, U1.39 (XTAL), Y1.1
unnamed: C2.1, U1.38 (EXTAL), Y1.2
unnamed: J1.2, R8.2
unnamed: J1.3, R9.2
unnamed: R8.1, U3.6 (Tx_Data)
unnamed: R9.1, U3.2 (Rx_Data)
unnamed: U3.5 (~RTS), U3.24 (~CTS)
OT_CS: U4-G1V3.15 (I/O/Q15)
PR_CS: U4-G1V3.16 (I/O/Q16)
Q: U1.35 (Q)
RAM_CS: U4.22 (~CE1), U4-G1V3.21 (I/O/Q21)
RAM_OE: U4.24 (~OE), U4-G1V3.19 (I/O/Q18)
RAM_WE: U4.29 (WE_), U4-G1V3.18 (I/O/Q19)
RESET_: C3.1, D1.2 (A), R7.2, SW1.2, U1.37 (~RESET)
ROM_0E: U2.22 (~OE)
ROM_CS: U2.20 (~CE), U4-G1V3.23 (I/O/Q23)
ROM_OE: U4-G1V3.22 (I/O/Q22)
RW_: U1.32 (R/~W), U3.13 (R/~W), U4-G1V3.8 (I8)
VCC: C4.1, C5.1, C6.1, C7.1, C8.1, C9.1, D1.1 (K), R1.2, R2.2, R3.2, R4.2, R5.2, R6.2, R7.1, U1.7 (VCC), U2.28 (VCC), U3.8 (CS0), U3.10 (CS1), U3.12 (VCC), U4.28 (A13), U4.30 (~CE2), U4-G1V3.24 (VCC), U5-G2V2.24 (VCC)
VRAM_SC: U4-G1V3.20 (I/O/Q20)

Notes on the sheet:
Memory Map
57600 8n1
0000-DFFF : 56K RAM E000-F7FF : 6K VRAM (EXT) F800-F801 : 2b MC6850 F802-F802 : 1b PR F803-F803 : 1b OT F804-FFFF : ~2K ROM
