inaciose/MC6809x/(commit log)

2025-08-08 jeff tranter fw & others
    [MC6809_SBC1.kicad_pcb, MC6809_SBC1.kicad_sch, bom.ods, clock_new.kicad_sch]
2025-08-09 SBC1 scheme a& other stuff
    [MC6809_SBC1.kicad_sch, clock_new.kicad_sch]
2025-08-17 Add bread board photo. SBC2, 2 gals only
    Full memory map, with out page in/out ROM/RAM and VRAM/RAM
2025-08-18 56K ram, Bread board photo
    64k IC
2025-08-24 M6809_SBC2 OK
    [MC6809_SBC2.kicad_pcb, MC6809_SBC2.kicad_sch]
2025-08-31 Single step circuit
    6809 Design: Controller or System. Microcomputer, Nov 1980.
